brvdg/busputer/BusPuter_assambly.jpeg

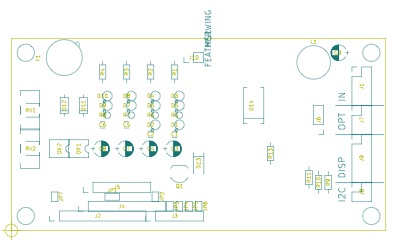
BusPuter_assambly.jpeg
