brvdg/busputer/BusPuter_layout.jpeg

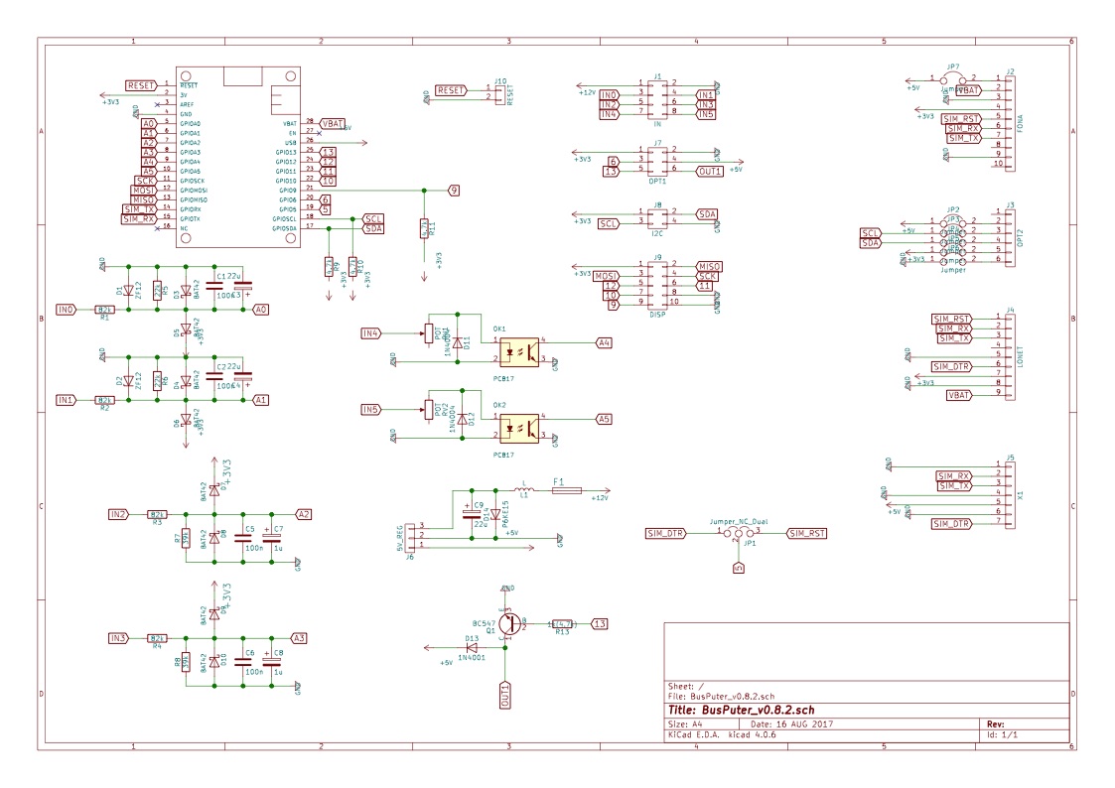
BusPuter_layout.jpeg
