brvdg/busputer/(commit log)

2017-01-09 add Arduino files
2017-01-10 add pcb
2017-01-11 add Arduino source
